RohanDhameja/Project-CleanLoom/README.md

# CleanLoom: Lint Control Solution for Small Weaving Workshops

## Project Overview

**Mission**: Develop a low-cost, practical lint reduction system for small weaving workshops in India to improve worker health, productivity, and fabric quality.

## The Problem

Small weaving workshops across India face serious lint accumulation issues:
- Workers exposed to airborne cotton fibers for extended periods
- Health impacts: respiratory issues, eye irritation, throat problems
- Productivity loss due to machine maintenance and cleaning
- Reduced fabric quality from lint contamination
- Increased machinery wear and maintenance costs

## Project Status

🚀 **Phase**: Problem Definition & Research  
📅 **Started**: December 2025  
👥 **Team**: [Add team members]

## 🚀 New to the Project?

**→ Start with [START_HERE.md](./START_HERE.md)** - Simple guide, not overwhelming!

**→ Need to set up for your team?** See [TEAM_SETUP.md](./TEAM_SETUP.md)

**→ Ready to deploy?** See [DEPLOYMENT_GUIDE.md](./DEPLOYMENT_GUIDE.md)

## Quick Navigation

- **[Project Plan](./01_Project_Plan/PROJECT_ROADMAP.md)** - Detailed timeline and milestones
- **[Problem Research](./02_Problem_Research/)** - Evidence, data, and analysis
- **[Solution Ideas](./03_Solution_Ideation/)** - Brainstorming and concepts
- **[Prototypes](./04_Prototypes/)** - Design files and prototypes
- **[Testing & Validation](./05_Testing/)** - Field tests and feedback
- **[Documentation](./06_Documentation/)** - Technical docs and guides
- **[Business Planning](./07_Business/)** - Cost analysis and implementation

## Current Focus

1. Complete problem documentation and evidence gathering
2. Conduct stakeholder interviews with workshop owners and workers
3. Research existing solutions and identify gaps
4. Begin solution ideation and concept development

## How to Contribute

This project follows a structured problem-solving approach:
1. Understand the problem deeply
2. Generate multiple solution concepts
3. Evaluate and select promising solutions
4. Build and test prototypes
5. Iterate based on feedback
6. Plan for implementation and scale

---

*Last Updated: December 3, 2025*
