RohanDhameja/Project-CleanLoom/01_Project_Plan/PROJECT_ROADMAP.md

# CleanLoom Project Roadmap

## Vision Statement

Create an affordable, effective lint control solution that can be adopted by hundreds of small weaving workshops across India, improving worker health and workshop productivity without disrupting traditional weaving practices.

---

## Project Phases

### Phase 1: Problem Definition & Research (Weeks 1-4)

**Goal**: Deeply understand the problem, stakeholders, and context

#### Week 1-2: Problem Documentation
- [ ] Document current problem with photos and evidence
- [ ] Create stakeholder map (workers, owners, suppliers, buyers)
- [ ] List all problem impacts (health, productivity, quality, costs)
- [ ] Define success metrics (lint reduction %, cost, ease of use)

#### Week 3-4: Field Research
- [ ] Visit 5-10 workshops to observe and document
- [ ] Interview workshop owners about pain points and budgets
- [ ] Interview workers about daily challenges
- [ ] Measure room dimensions, lint density, airflow patterns
- [ ] Document existing coping mechanisms

**Deliverables**:
- Problem statement document
- Stakeholder interview summaries
- Workshop measurement data
- Photo/video documentation

---

### Phase 2: Research & Benchmarking (Weeks 5-6)

**Goal**: Learn from existing solutions and identify opportunities

#### Tasks
- [ ] Research industrial lint control systems
- [ ] Study low-cost filtration methods
- [ ] Investigate natural ventilation solutions
- [ ] Review DIY air filtration projects
- [ ] Analyze competitors and alternatives
- [ ] Identify technology constraints (power, space, cost)

**Deliverables**:
- Competitive analysis document
- Technology research report
- Constraint and requirement list

---

### Phase 3: Solution Ideation (Weeks 7-8)

**Goal**: Generate multiple solution concepts

#### Brainstorming Sessions
- [ ] Individual brainstorming (quantity over quality)
- [ ] Team brainstorming sessions
- [ ] Sketch 20+ different concepts
- [ ] Consider: filtration, ventilation, capture, prevention
- [ ] Think: low-tech, mid-tech, high-tech options

#### Solution Categories to Explore
1. **Air Filtration**: Box fans with filters, ceiling-mounted units
2. **Ventilation**: Passive vents, exhaust fans, air circulation
3. **Source Capture**: Attachments to looms, localized suction
4. **Protective Equipment**: Improved masks, protective gear
5. **Maintenance Tools**: Cleaning equipment, schedules
6. **Hybrid Approaches**: Combining multiple methods

**Deliverables**:
- 20+ solution sketches/concepts
- Initial feasibility assessment

---

### Phase 4: Concept Evaluation & Selection (Weeks 9-10)

**Goal**: Narrow down to 2-3 most promising solutions

#### Evaluation Criteria
- **Cost**: Can it be built for under ₹5,000-10,000?
- **Effectiveness**: Will it reduce lint by 50%+?
- **Ease of Use**: Can users operate and maintain it?
- **Durability**: Will it last 2+ years with minimal maintenance?
- **Scalability**: Can it be replicated across workshops?
- **Cultural Fit**: Does it align with existing practices?

#### Tasks
- [ ] Create evaluation matrix
- [ ] Score each concept against criteria
- [ ] Get feedback from potential users
- [ ] Select top 2-3 concepts for prototyping
- [ ] Create detailed design specifications

**Deliverables**:
- Evaluation matrix with scores
- Top 3 selected concepts
- Design specifications document

---

### Phase 5: Prototype Development (Weeks 11-14)

**Goal**: Build working prototypes of selected solutions

#### Prototype 1 (Week 11-12)
- [ ] Source materials locally
- [ ] Build first prototype
- [ ] Basic functionality testing
- [ ] Document build process and costs

#### Prototype 2 (Week 12-13)
- [ ] Build second concept prototype
- [ ] Compare performance with Prototype 1
- [ ] Identify improvements needed

#### Prototype 3 (Week 13-14)
- [ ] Build third concept (if needed)
- [ ] Refine most promising design
- [ ] Create build instructions

**Deliverables**:
- 2-3 working prototypes
- Build documentation with photos
- Bill of materials with costs
- Performance test results

---

### Phase 6: Field Testing (Weeks 15-18)

**Goal**: Test prototypes in real workshop conditions

#### Testing Plan
- [ ] Install prototypes in 3-5 workshops
- [ ] Run for 2-4 weeks in real conditions
- [ ] Measure lint reduction (before/after)
- [ ] Collect user feedback daily/weekly
- [ ] Document failures and issues
- [ ] Monitor worker satisfaction
- [ ] Measure impact on productivity

#### Metrics to Track
- Lint density (visual/measured)
- User satisfaction (surveys)
- Downtime for cleaning
- Fabric quality improvements
- Maintenance required
- Cost of operation

**Deliverables**:
- Field test report
- User feedback summaries
- Performance data
- Improvement recommendations

---

### Phase 7: Iteration & Refinement (Weeks 19-20)

**Goal**: Improve the design based on field feedback

#### Tasks
- [ ] Analyze all feedback and data
- [ ] Identify design improvements
- [ ] Build refined prototype v2.0
- [ ] Test improvements
- [ ] Finalize design for production

**Deliverables**:
- Refined prototype
- Final design specifications
- Manufacturing guidelines

---

### Phase 8: Documentation & Planning (Weeks 21-22)

**Goal**: Prepare for implementation and scaling

#### Tasks
- [ ] Create user manual (with visuals)
- [ ] Create installation guide
- [ ] Create maintenance schedule
- [ ] Document troubleshooting steps
- [ ] Calculate cost structure
- [ ] Plan manufacturing/distribution
- [ ] Create training materials

**Deliverables**:
- Complete user documentation
- Business plan for scaling
- Training materials
- Cost and pricing analysis

---

### Phase 9: Pilot Implementation (Weeks 23-26)

**Goal**: Deploy to 10-20 workshops

#### Tasks
- [ ] Select pilot workshop locations
- [ ] Train workshop owners
- [ ] Install systems
- [ ] Provide ongoing support
- [ ] Monitor performance
- [ ] Gather case studies

**Deliverables**:
- 10-20 installations
- Case studies and testimonials
- Impact report

---

### Phase 10: Scale & Outreach (Ongoing)

**Goal**: Expand adoption across India

#### Tasks
- [ ] Partner with weaving associations
- [ ] Seek funding/grants
- [ ] Build production partnerships
- [ ] Create marketing materials
- [ ] Measure community impact

---

## Key Milestones

| Milestone | Target Date | Status |
|---|---|---|
| Project kickoff | Week 1 | ✅ |
| Problem documentation complete | Week 2 | 🔄 |
| Field research complete | Week 4 | ⏳ |
| Solution concepts generated | Week 8 | ⏳ |
| Top concepts selected | Week 10 | ⏳ |
| First prototype built | Week 12 | ⏳ |
| Field testing begins | Week 15 | ⏳ |
| Design finalized | Week 20 | ⏳ |
| Pilot deployment complete | Week 26 | ⏳ |

**Legend**: ✅ Complete | 🔄 In Progress | ⏳ Upcoming

---

## Success Metrics

### Primary Metrics
- **Lint Reduction**: 50%+ reduction in airborne and settled lint
- **Cost**: Solution costs ≤ ₹10,000 per workshop
- **Adoption**: 50+ workshops using the solution within 1 year
- **Health**: 70%+ of workers report reduced respiratory issues

### Secondary Metrics
- Fabric quality improvement (fewer defects)
- Reduced machine maintenance frequency
- Increased daily productivity
- Worker satisfaction scores
- Workshop owner satisfaction

---

## Risk Management

| Risk | Impact | Mitigation |
|---|---|---|
| Solution too expensive | High | Focus on local materials, DIY assembly |
| Low adoption rate | High | Co-design with users, ensure cultural fit |
| Ineffective lint reduction | High | Test multiple approaches, iterate quickly |
| Maintenance too complex | Medium | Design for simplicity, create clear guides |
| Funding limitations | Medium | Start small, bootstrap, seek grants later |

---

## Team Roles (To Be Assigned)

- **Project Lead**: Overall coordination and decision-making
- **Research Lead**: Field studies and user interviews
- **Design/Engineering**: Prototype development
- **Testing**: Field testing and data collection
- **Documentation**: Creating guides and materials
- **Business/Operations**: Scaling and partnerships

---

## Budget Planning

### Phase 1-4 (Research & Design): ₹20,000-30,000
- Travel to workshops
- Documentation tools
- Research materials

### Phase 5-6 (Prototyping & Testing): ₹50,000-100,000
- Materials for 3 prototypes
- Testing equipment
- Installation costs

### Phase 7-9 (Refinement & Pilot): ₹200,000-300,000
- Refined prototypes
- Pilot installations (10-20 units)
- Training and support

### Phase 10 (Scale): TBD
- Manufacturing partnerships
- Marketing and outreach
- Ongoing support

---

*Last Updated: December 3, 2025*
