RohanDhameja/Project-CleanLoom/START_HERE.md

# 👋 Welcome to CleanLoom!

## What is this project?

We're creating a **low-cost solution to reduce lint** in small weaving workshops in India. This will help thousands of workers breathe cleaner air and work in better conditions.

---

## 🚀 New to the project? Start here!

### Step 1: Understand the Problem (5 minutes)

Read this one file:
- **[02_Problem_Research/INITIAL_EVIDENCE.md](02_Problem_Research/INITIAL_EVIDENCE.md)**

That's it! This tells you everything about what we're trying to solve.

---

### Step 2: Know What Phase We're In (2 minutes)

Check the **[Current Status](#current-status)** section below to see what we're working on right now.

---

### Step 3: Jump In!

Based on what we're doing now, pick ONE action:

**If we're doing research:**
- Join a workshop visit (we'll give you templates)
- Review workshop photos
- Talk to a weaver

**If we're brainstorming:**
- Join a brainstorming session
- Sketch 5 ideas
- Research similar solutions

**If we're building:**
- Help build a prototype
- Test something
- Take photos

**If we're testing:**
- Visit a test site
- Collect feedback
- Measure results

---

## 📍 Current Status

**Phase**: Problem Research & Documentation  
**Week**: 1 of 26  
**Focus**: Understanding the problem deeply

**This Week's Goals:**
- [ ] Visit 3-5 workshops
- [ ] Interview workshop owners
- [ ] Take lots of photos
- [ ] Document what we see

**How you can help right now:**
- Review the workshop photos we have
- Come on a workshop visit
- Share ideas about solutions you've seen

---

## 📚 Need More Detail?

**Most people won't need these**, but they're here if you want to go deeper:

### Quick Guides (read if you're doing this task)
- Going on a workshop visit? → [Field Observation Template](02_Problem_Research/FIELD_OBSERVATION_TEMPLATE.md)
- Interviewing someone? → [Interview Template](02_Problem_Research/INTERVIEW_TEMPLATE.md)
- Want the full timeline? → [Project Roadmap](01_Project_Plan/PROJECT_ROADMAP.md)

### Reference Documents (use when you need them)
- [Full Project Guide](PROJECT_GUIDE.md) - How everything works
- [Folder Structure](FOLDER_STRUCTURE.md) - Where to save what
- [README](README.md) - Detailed project overview

---

## ❓ Common Questions

**Q: Do I need to read everything?**  
**A:** No! Just read INITIAL_EVIDENCE.md and check Current Status above. That's enough to start.

**Q: Where do I save my work?**  
**A:** We'll show you when you need to. Don't worry about it yet.

**Q: What if I have an idea?**  
**A:** Share it! Text/WhatsApp/email anyone on the team, or just tell us in person.

**Q: I'm confused about something**  
**A:** Ask anyone on the team. We're all learning together.

**Q: Can I change these documents?**  
**A:** Yes! That's the whole point. If something isn't clear, make it better.

---

## 👥 Team

**Core Team:**
- [Add names and roles]
- Contact: [Add contact info]

**How we work:**
- Weekly check-ins: [Day/Time]
- Communication: [WhatsApp group / Slack / Email]
- Questions: Just ask!

---

## 🎯 The Big Picture (Simple Version)

### The Problem
Workers in weaving workshops breathe lint-filled air all day. It's bad for their health.

### Our Goal
Create a simple, cheap solution (under ₹10,000) that removes 50%+ of the lint from the air.

### How We'll Do It
1. **Understand** the problem (Weeks 1-6)
2. **Brainstorm** solutions (Weeks 7-10)
3. **Build** prototypes (Weeks 11-18)
4. **Test** in real workshops (Weeks 15-20)
5. **Deploy** to many workshops (Weeks 21+)

### Success Looks Like
- Cleaner air in workshops
- Healthier workers
- Better fabric quality
- 50+ workshops using our solution in 1 year

---

## 📅 This Week's Schedule

**Monday**: [Add activity]  
**Wednesday**: [Add activity]  
**Friday**: [Add activity]

**Next workshop visit**: [Date/Time/Location]

---

## 🎉 Quick Wins

Let's celebrate small progress:
- ✅ Project structure set up
- ⏳ First workshop visit
- ⏳ First interview completed
- ⏳ 10 solution ideas
- ⏳ First prototype built

---

## 💡 Remember

- **Start small** - You don't need to understand everything
- **Ask questions** - No question is too basic
- **One step at a time** - We'll guide you through each phase
- **It's okay to be confused** - This is complex, we're figuring it out together
- **You belong here** - Your perspective is valuable

---

## 🔗 Quick Links

**For today:**
- [What's the problem?](02_Problem_Research/INITIAL_EVIDENCE.md) ← **Start here**

**When you need them:**
- [Workshop visit checklist](02_Problem_Research/FIELD_OBSERVATION_TEMPLATE.md)
- [Interview questions](02_Problem_Research/INTERVIEW_TEMPLATE.md)
- [Full roadmap](01_Project_Plan/PROJECT_ROADMAP.md)
- [How to use this project](PROJECT_GUIDE.md)

---

**Ready? Read [INITIAL_EVIDENCE.md](02_Problem_Research/INITIAL_EVIDENCE.md) and you're good to go!** 🚀

---

*Last Updated: December 3, 2025*  
*Questions? Contact: [Add contact]*
