RohanDhameja/Project-CleanLoom/graphs/g10_timeline_gantt.png

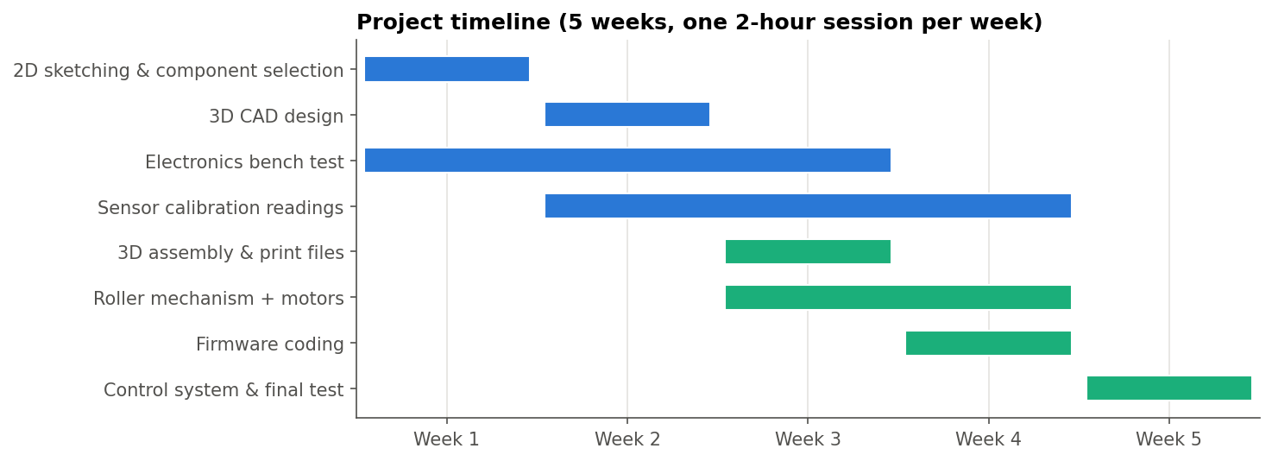
graphs/g10_timeline_gantt.png
