RohanDhameja/Project-CleanLoom/images/photo13_electronics_in_base_3.jpg

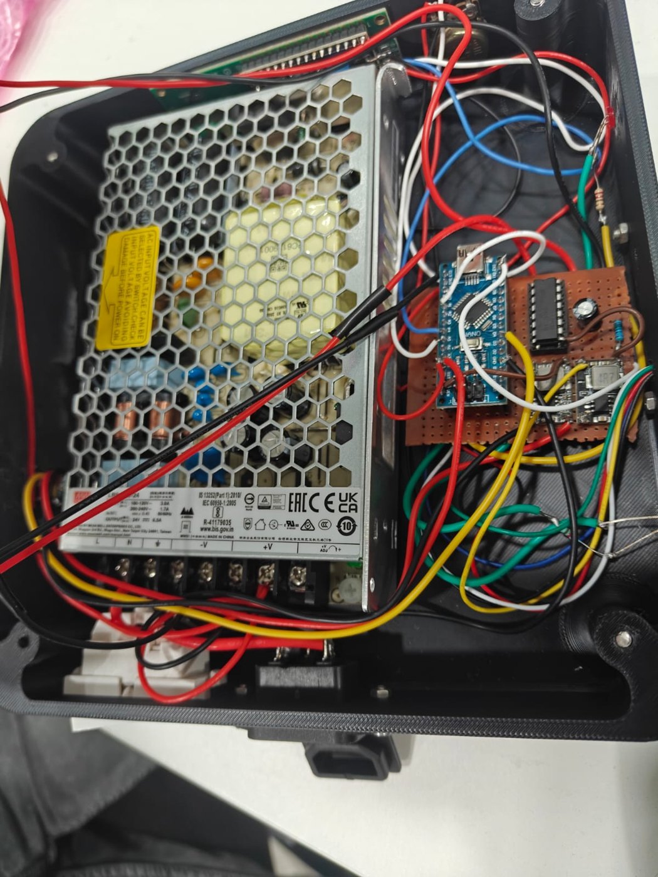
images/photo13_electronics_in_base_3.jpg
