RohanDhameja/Project-CleanLoom/NEXT_STEPS_PLAN.md

# Next Steps Plan - Answering Key Questions

## Question 1: What are the next steps? How do we proceed?

### Immediate Next Steps (This Week - Week 1)

**Step 1: Consolidate What We Know (Days 1-2)**
- Collect all existing research from team members
- Document existing solutions they've found
- List all workshop observations we have
- Create a shared knowledge base

**Step 2: Plan Field Visits (Days 3-4)**
- Identify 5-10 workshops to visit (with permission)
- Prepare observation checklist
- Prepare interview questions
- Schedule visits

**Step 3: First Field Visit (Day 5)**
- Visit 2-3 workshops
- Take photos and measurements
- Interview owners and workers
- Document everything

### Short-Term Steps (Weeks 2-4)

**Week 2: Deep Research**
- Complete 5-10 workshop visits
- Document all findings
- Research existing solutions in detail
- Identify gaps and opportunities

**Week 3: Analysis**
- Analyze all collected data
- Identify patterns and common problems
- Understand constraints (cost, space, power, etc.)
- Define success criteria

**Week 4: Solution Ideation**
- Brainstorm 20+ solution concepts
- Consider multiple approaches (technical, behavioral, hybrid)
- Evaluate initial feasibility
- Select 3-5 concepts for deeper exploration

### Medium-Term Steps (Weeks 5-12)

**Weeks 5-8: Prototype Development**
- Build 2-3 prototype solutions
- Test in controlled environment
- Refine designs
- Calculate costs

**Weeks 9-12: Field Testing**
- Install prototypes in 3-5 workshops
- Test for 2-4 weeks
- Collect feedback
- Measure effectiveness

### Long-Term Steps (Weeks 13+)

**Weeks 13-16: Refinement**
- Improve designs based on feedback
- Finalize solution
- Create user documentation

**Weeks 17-20: Pilot Deployment**
- Deploy to 10-20 workshops
- Provide training and support
- Monitor performance

**Weeks 21+: Scale**
- Expand to more workshops
- Build partnerships
- Measure impact

---

## Question 2: What will be the nature of the solution?

### Our Approach: **Hybrid Solution** (Technical + Behavioral + Social)

We believe the solution needs multiple components:

### 1. **Technical Component** (Primary)
**What:** A physical device/system that removes lint from the air

**Options we're exploring:**
- Air filtration systems (fans + filters)
- Ventilation improvements
- Source capture (capturing lint at the loom)
- Combination approaches

**Why technical is needed:**
- The problem is physical (airborne lint)
- Requires a physical intervention
- Can be measured objectively

**Constraints:**
- Must be affordable (under ₹10,000)
- Must use minimal power
- Must be simple to install and maintain
- Must work in existing workshop spaces

### 2. **Behavioral Component** (Supporting)
**What:** Changes in how workshops operate

**Examples:**
- Regular cleaning schedules
- Proper maintenance routines
- Usage protocols for the technical solution

**Why behavioral is needed:**
- Technical solutions only work if used correctly
- Maintenance is critical for long-term success
- Workers need to adopt new habits

**How we'll address it:**
- Simple, visual instructions
- Training sessions
- Easy-to-follow maintenance schedules
- Design for "set and forget" where possible

### 3. **Social Component** (Enabling)
**What:** Community support and adoption

**Examples:**
- Peer learning (workshop owners teaching each other)
- Group purchasing for better prices
- Sharing success stories
- Building trust in the solution

**Why social is needed:**
- Small workshops learn from each other
- Group adoption creates momentum
- Community validation increases trust
- Can reduce costs through bulk purchasing

**How we'll address it:**
- Start with a few pilot workshops
- Document success stories
- Create simple sharing mechanisms
- Build a network of early adopters

### 4. **Economic Component** (Critical)
**What:** Making it financially viable

**Considerations:**
- Affordable initial cost
- Low operating costs
- Clear ROI for workshop owners
- Potential financing options

**Why economic is critical:**
- Small workshops operate on tight margins
- Must demonstrate value quickly
- May need payment plans or subsidies

---

### Most Likely Solution Type: **Technical (with behavioral support)**

**Primary:** A low-cost air filtration or ventilation system
**Supporting:** Simple maintenance protocols and usage guidelines
**Enabling:** Community adoption and peer learning

**Why this combination:**
- Technical solution addresses the root cause (airborne lint)
- Behavioral component ensures it's used effectively
- Social component enables adoption at scale

---

## Question 3: How are we going to collect pictorial evidence?

### Evidence Collection Strategy

### Phase 1: Permission & Planning (Before Visits)

**Step 1: Get Consent**
- Contact workshop owners in advance
- Explain the project purpose
- Ask permission to photograph
- Offer to share photos with them
- Respect privacy requests (blur faces if needed)

**Step 2: Prepare Equipment**
- Smartphone cameras (most accessible)
- Optional: DSLR for better quality
- Measuring tape for scale
- Notebook for notes

**Step 3: Plan What to Capture**
- Wide shots of entire workshop
- Close-ups of lint accumulation
- Machine details showing lint buildup
- Ceiling and walls showing dust
- Workers (with permission)
- Ventilation points (or lack thereof)
- Any existing solutions they've tried

### Phase 2: During Visits

**Photo Checklist:**

**Workshop Overview:**
- [ ] Exterior of workshop
- [ ] Interior wide shot showing all looms
- [ ] Layout and spacing

**Lint Evidence:**
- [ ] Close-up of lint on machines (gears, frames)
- [ ] Lint on ceiling and walls
- [ ] Lint on floor
- [ ] Lint on fabric being woven
- [ ] Airborne lint (if visible in light beam)

**Infrastructure:**
- [ ] Ventilation (windows, doors, fans)
- [ ] Electrical setup
- [ ] Room dimensions (use person/object for scale)
- [ ] Ceiling height

**People & Process:**
- [ ] Workers (with permission, faces blurred if requested)
- [ ] Loom operation
- [ ] Cleaning activities
- [ ] Any protective equipment used

**Existing Solutions:**
- [ ] Any filters or devices already installed
- [ ] Cleaning tools and methods
- [ ] What they've tried before

### Phase 3: Organization & Storage

**File Naming Convention:**
```
YYYYMMDD_Location_Subject_###.jpg

Examples:
20251203_Workshop_A_LintOnMachine_001.jpg
20251203_Workshop_A_WideShot_002.jpg
20251203_Workshop_B_CeilingLint_001.jpg
```

**Storage:**
- Upload to GitHub: `08_Assets/Photos/Workshop_Photos/`
- Also backup to Google Drive or similar
- Create a simple spreadsheet listing all photos with descriptions

**Privacy:**
- Get written/verbal consent before photographing people
- Blur faces if requested
- Don't share identifiable photos publicly without permission
- Keep contact information private

### Phase 4: Documentation

**For Each Photo:**
- Date and location
- What it shows
- Why it's important
- Any relevant measurements or notes

**Create Photo Log:**
- Simple spreadsheet or document
- Links photos to observations
- Makes it easy to find specific evidence later

---

### Practical Tips for Evidence Collection

**1. Start with Phone Cameras**
- Everyone has one
- Good enough quality
- Easy to share immediately
- Can upgrade later if needed

**2. Take More Than You Think You Need**
- Better to have too many than too few
- Can delete later
- Different angles tell different stories

**3. Include Scale References**
- Person standing next to machine
- Common object (water bottle, notebook)
- Measuring tape visible in shot

**4. Document Context**
- What was happening when photo was taken?
- Time of day
- How many looms were running
- Any unusual conditions

**5. Respect Privacy**
- Always ask before photographing people
- Explain how photos will be used
- Offer to share copies with workshop owners
- Blur faces if requested

**6. Show Before/After (Later)**
- When testing solutions, take photos from same angles
- Makes impact visible and compelling

---

### Timeline for Evidence Collection

**Week 1-2:** 
- Visit 5-10 workshops
- Collect 50-100 photos
- Document all observations

**Week 3:**
- Organize and catalog all photos
- Create photo log
- Identify gaps (need more photos of X)

**Week 4:**
- Fill gaps with additional visits if needed
- Finalize evidence collection
- Use photos in problem documentation

**Ongoing:**
- Continue collecting photos during testing
- Document prototypes and results
- Build before/after comparison library

---

## Summary: Answering Your Friend's Questions

### 1. Next Steps:
- **This week:** Consolidate existing knowledge, plan field visits
- **Weeks 2-4:** Deep research, visit 5-10 workshops, analyze findings
- **Weeks 5-12:** Build and test prototypes
- **Weeks 13+:** Refine and scale

### 2. Solution Nature:
- **Primary:** Technical (air filtration/ventilation system)
- **Supporting:** Behavioral (maintenance protocols)
- **Enabling:** Social (community adoption)
- **Critical:** Economic (affordable, clear ROI)

### 3. Pictorial Evidence:
- **Permission first:** Always ask before photographing
- **Systematic approach:** Use checklist, consistent naming
- **Privacy respect:** Blur faces if requested, get consent
- **Organization:** Store in GitHub, create photo log
- **Timeline:** Collect 50-100 photos in first 2 weeks

---

*This plan ensures we proceed systematically while respecting the people and places we're working with.*
