RohanDhameja/Project-CleanLoom/data/04_filtration_performance_test.csv

minute | phase | fan_state | dust_mg_m3 | threshold_mg_m3 | warning_led
0 | Site work ON, filter OFF | OFF | 6.2 | 10 | OFF
1 | Site work ON, filter OFF | OFF | 7.63 | 10 | OFF
2 | Site work ON, filter OFF | OFF | 9.31 | 10 | OFF
3 | Site work ON, filter OFF | OFF | 8.64 | 10 | OFF
4 | Site work ON, filter OFF | OFF | 9.15 | 10 | OFF
5 | Site work ON, filter OFF | OFF | 11.18 | 10 | ON
6 | Site work ON, filter OFF | OFF | 9.56 | 10 | OFF
7 | Site work ON, filter OFF | OFF | 10.09 | 10 | ON
8 | Site work ON, filter OFF | OFF | 12.54 | 10 | ON
9 | Site work ON, filter OFF | OFF | 13.37 | 10 | ON
10 | Site work ON, filter OFF | OFF | 14.19 | 10 | ON
11 | Site work ON, filter OFF | OFF | 12.35 | 10 | ON
12 | Site work ON, filter OFF | OFF | 12.02 | 10 | ON
13 | Site work ON, filter OFF | OFF | 13.77 | 10 | ON
14 | Site work ON, filter OFF | OFF | 13.2 | 10 | ON
15 | Site work ON, filter OFF | OFF | 14.15 | 10 | ON
16 | Site work ON, filter OFF | OFF | 14.09 | 10 | ON
17 | Site work ON, filter OFF | OFF | 12.83 | 10 | ON
18 | Site work ON, filter OFF | OFF | 13.5 | 10 | ON
19 | Site work ON, filter OFF | OFF | 11.87 | 10 | ON
20 | Site work ON, filter OFF | OFF | 13.11 | 10 | ON
21 | Site work ON, filter OFF | OFF | 15.38 | 10 | ON
22 | Site work ON, filter OFF | OFF | 14.75 | 10 | ON
23 | Site work ON, filter OFF | OFF | 13.76 | 10 | ON
24 | Site work ON, filter OFF | OFF | 13.19 | 10 | ON
25 | Site work ON, filter OFF | OFF | 14.99 | 10 | ON
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
163 | Site work OFF, filter ON | ON | 3.44 | 10 | OFF
164 | Site work OFF, filter ON | ON | 2.76 | 10 | OFF
165 | Site work OFF, filter ON | ON | 3.43 | 10 | OFF
166 | Site work OFF, filter ON | ON | 2.68 | 10 | OFF
167 | Site work OFF, filter ON | ON | 2.91 | 10 | OFF
168 | Site work OFF, filter ON | ON | 3.36 | 10 | OFF
169 | Site work OFF, filter ON | ON | 3.1 | 10 | OFF
170 | Site work OFF, filter ON | ON | 3.21 | 10 | OFF
171 | Site work OFF, filter ON | ON | 3.07 | 10 | OFF
172 | Site work OFF, filter ON | ON | 3.07 | 10 | OFF
173 | Site work OFF, filter ON | ON | 2.59 | 10 | OFF
174 | Site work OFF, filter ON | ON | 2.25 | 10 | OFF
175 | Site work OFF, filter ON | ON | 3.53 | 10 | OFF
176 | Site work OFF, filter ON | ON | 2.35 | 10 | OFF
177 | Site work OFF, filter ON | ON | 2.8 | 10 | OFF
178 | Site work OFF, filter ON | ON | 2.73 | 10 | OFF
179 | Site work OFF, filter ON | ON | 2.92 | 10 | OFF
