RohanDhameja/Project-CleanLoom/03_Solution_Ideation/EVALUATION_FRAMEWORK.md

# Solution Evaluation Framework

## Purpose

This framework helps evaluate and compare solution concepts to identify the most promising approaches for prototyping. Use this after the ideation phase to narrow down from 20+ concepts to 2-3 finalists.

---

## Evaluation Process

### Step 1: Initial Screening
Remove ideas that are clearly not feasible due to:
- Far exceeds budget (>₹50,000)
- Requires unavailable technology
- Not culturally appropriate
- Violates safety standards

### Step 2: Criteria-Based Scoring
Score remaining concepts using the matrix below

### Step 3: User Feedback
Get input from 3-5 potential users on top 8-10 concepts

### Step 4: Final Selection
Select 2-3 concepts for prototyping based on scores + user feedback

---

## Evaluation Criteria Matrix

### Criteria & Weighting

| Criteria | Weight | Why It Matters |
|---|---|---|
| Cost | 20% | Must be affordable for small workshops |
| Effectiveness | 25% | Must significantly reduce lint (50%+) |
| Ease of Use | 15% | Users have limited technical skills |
| Ease of Maintenance | 10% | Ongoing complexity will lead to abandonment |
| Installation Difficulty | 10% | Cannot disrupt work for long |
| Durability | 10% | Must last 2+ years with minimal repair |
| Scalability | 5% | Can it work for 1 loom or 10 looms? |
| Safety | 5% | Cannot introduce new hazards |

**Total: 100%**

---

## Scoring Guide

**For each criterion, rate 1-5:**

### 1. Cost (20% weight)

| Score | Cost Range | Description |
|---|---|---|
| 5 | < ₹5,000 | Extremely affordable |
| 4 | ₹5,000-8,000 | Very affordable |
| 3 | ₹8,000-12,000 | Affordable |
| 2 | ₹12,000-20,000 | Expensive but possible |
| 1 | > ₹20,000 | Too expensive |

---

### 2. Effectiveness (25% weight)

| Score | Lint Reduction | Description |
|---|---|---|
| 5 | 80-100% | Dramatic improvement |
| 4 | 60-80% | Significant improvement |
| 3 | 40-60% | Noticeable improvement |
| 2 | 20-40% | Marginal improvement |
| 1 | < 20% | Minimal improvement |

*Note: Estimates are okay at this stage*

---

### 3. Ease of Use (15% weight)

| Score | Complexity | Description |
|---|---|---|
| 5 | Passive | No user action required (set and forget) |
| 4 | Very Simple | On/off switch only |
| 3 | Simple | Few controls, intuitive |
| 2 | Moderate | Requires some training |
| 1 | Complex | Requires technical knowledge |

---

### 4. Ease of Maintenance (10% weight)

| Score | Maintenance | Description |
|---|---|---|
| 5 | < 15 min/month | Minimal maintenance |
| 4 | 15-30 min/week | Weekly simple tasks |
| 3 | 30-60 min/week | Regular cleaning/adjustment |
| 2 | > 1 hr/week | Significant maintenance |
| 1 | Professional service needed | Requires technician |

---

### 5. Installation Difficulty (10% weight)

| Score | Installation | Description |
|---|---|---|
| 5 | < 2 hours | Plug and play or very simple mounting |
| 4 | Half day | DIY with basic tools |
| 3 | 1 day | DIY with some help |
| 2 | 2-3 days | Requires some expertise |
| 1 | > 3 days | Requires professional installation |

---

### 6. Durability (10% weight)

| Score | Lifespan | Description |
|---|---|---|
| 5 | 5+ years | Extremely durable |
| 4 | 3-5 years | Very durable |
| 3 | 2-3 years | Adequate durability |
| 2 | 1-2 years | May need replacement |
| 1 | < 1 year | Poor durability |

---

### 7. Scalability (5% weight)

| Score | Scalability | Description |
|---|---|---|
| 5 | Fully modular | Works for 1-20 looms easily |
| 4 | Highly scalable | Minor adjustments needed |
| 3 | Moderately scalable | Some redesign for different sizes |
| 2 | Limited scalability | Only works for specific setup |
| 1 | Not scalable | Fixed size only |

---

### 8. Safety (5% weight)

| Score | Safety | Description |
|---|---|---|
| 5 | Very safe | No safety concerns |
| 4 | Safe | Minor precautions needed |
| 3 | Acceptable | Moderate safety measures needed |
| 2 | Concerning | Significant safety concerns |
| 1 | Unsafe | Creates new hazards |

---

## Scoring Template

Use this table for each concept:

```
CONCEPT NAME: _______________________________

| Criterion | Raw Score (1-5) | Weight | Weighted Score |
|-----------|----------------|--------|----------------|
| Cost | ___ | × 0.20 | = ____ |
| Effectiveness | ___ | × 0.25 | = ____ |
| Ease of Use | ___ | × 0.15 | = ____ |
| Ease of Maintenance | ___ | × 0.10 | = ____ |
| Installation Difficulty | ___ | × 0.10 | = ____ |
| Durability | ___ | × 0.10 | = ____ |
| Scalability | ___ | × 0.05 | = ____ |
| Safety | ___ | × 0.05 | = ____ |
| **TOTAL** | | | **____** |

Max Possible Score: 5.0
```

---

## User Feedback Template

Show concepts to potential users and ask:

### Questions for Workshop Owners

1. **First Impression**: On a scale of 1-5, how interested are you in this solution?
   
   Score: _____

2. **Affordability**: Would you pay [estimated cost] for this?
   
   [ ] Yes [ ] Maybe [ ] No

3. **Concerns**: What worries you about this solution?
   
   ____________________________________________________________

4. **Confidence**: Do you think this would actually work in your workshop?
   
   [ ] Yes, definitely [ ] Probably [ ] Not sure [ ] Probably not [ ] No

---

### Questions for Workers

1. **Comfort**: Would you feel comfortable working with this running?
   
   [ ] Yes [ ] Maybe [ ] No - Why? _________________________

2. **Interference**: Do you think it would get in your way?
   
   [ ] No [ ] A little [ ] Yes, significantly

3. **Maintenance**: Could you maintain this yourself?
   
   [ ] Yes, easily [ ] Yes, with training [ ] Not sure [ ] No

---

## Comparison Matrix

Create a spreadsheet with all concepts as rows and criteria as columns:

| Concept | Cost | Effectiveness | Ease of Use | ... | **Total** | **Rank** |
|---|---|---|---|-----|---|---|
| Concept A | 4.0 | 3.5 | 4.0 | ... | 3.85 | 1 |
| Concept B | 3.0 | 4.5 | 3.0 | ... | 3.65 | 2 |
| ... | | | | | | |

---

## Additional Considerations

### Technical Feasibility Questions

For top concepts, answer:

- [ ] Can we source materials locally?
- [ ] Do we have the skills to build it?
- [ ] Can it be built with available tools?
- [ ] Are there any regulatory/compliance issues?
- [ ] What could go wrong during operation?

### Market Research

- Are similar solutions available commercially?
- If yes, why aren't they being used? (price, complexity, cultural fit?)
- Can we improve on existing solutions?

### Pilot Testing Suitability

- Can we build a prototype in 2-4 weeks?
- Is it safe to test in a real workshop?
- Can we measure its effectiveness?
- What metrics will we track?

---

## Decision Framework

### Must-Have Thresholds
- Total score: ≥ 3.5 / 5.0
- Cost score: ≥ 3
- Effectiveness score: ≥ 3
- Safety score: ≥ 4
- User feedback: ≥ 60% positive

### Selection Strategy

**Select 2-3 concepts that**:
1. Score highest overall
2. Represent different approaches (e.g., filtration + ventilation + source capture)
3. Have strong user enthusiasm
4. Have manageable risk profiles
5. Can be prototyped quickly

**Rationale for multiple concepts**:
- Prototypes may fail - have backups
- Different workshops may need different solutions
- Can combine best features later

---

## Documentation Requirements

For each selected concept, create:

1. **Detailed Design Sketch**
   - Dimensions, materials, components
   - How it works (step-by-step)
   
2. **Bill of Materials (BOM)**
   - Every component needed
   - Where to source locally
   - Cost breakdown

3. **Build Plan**
   - Tools required
   - Steps to construct
   - Estimated build time

4. **Testing Plan**
   - How to measure effectiveness
   - Safety checks
   - User feedback method

---

## Red Flags to Watch For

⚠️ **Be cautious if**:
- Solution requires rare/expensive materials
- Maintenance is complex or frequent
- Users express skepticism or confusion
- Safety concerns are raised
- Installation requires structural changes
- Operating costs are high (electricity, consumables)

---

## Next Steps After Evaluation

1. Finalize top 2-3 concepts
2. Get team consensus on selections
3. Create detailed build plans
4. Source materials
5. Begin prototyping (move to Phase 5 of roadmap)

---

*Remember: The goal is to find solutions that are good enough to test, not perfect*  
*Prototyping will reveal what works - stay flexible*
