RohanDhameja/Project-CleanLoom/data/01_GP2Y10_sensor_calibration_readings.csv

reading_no | test_week | condition | time | adc_value | sensor_voltage_V | raw_datasheet_mg_m3 | calculated_dust_mg_m3 | reference_meter_mg_m3 | abs_error_mg_m3 | error_pct | accuracy_pct
1 | Week 2 | Clean room baseline (fan off) | 10:21:00 | 167 | 0.816 | 0.0388 | 1.29 | 1.18 | 0.11 | 9.5 | 90.5
2 | Week 2 | Clean room baseline (fan off) | 10:21:31 | 195 | 0.953 | 0.062 | 2.07 | 1.64 | 0.43 | 26.1 | 73.9
3 | Week 2 | Clean room baseline (fan off) | 10:22:02 | 234 | 1.144 | 0.0944 | 3.15 | 2.45 | 0.7 | 28.5 | 71.5
4 | Week 2 | Clean room baseline (fan off) | 10:22:38 | 203 | 0.992 | 0.0687 | 2.29 | 2.05 | 0.24 | 11.7 | 88.3
5 | Week 2 | Clean room baseline (fan off) | 10:23:04 | 157 | 0.767 | 0.0304 | 1.01 | 1.16 | 0.15 | 12.5 | 87.5
6 | Week 2 | Clean room baseline (fan off) | 10:23:45 | 217 | 1.061 | 0.0803 | 2.68 | 2.44 | 0.24 | 9.7 | 90.3
7 | Week 2 | Clean room baseline (fan off) | 10:24:26 | 203 | 0.992 | 0.0687 | 2.29 | 2.45 | 0.16 | 6.6 | 93.4
8 | Week 2 | Clean room baseline (fan off) | 10:25:01 | 166 | 0.811 | 0.0379 | 1.26 | 1.31 | 0.05 | 3.5 | 96.5
9 | Week 2 | Clean room baseline (fan off) | 10:25:43 | 178 | 0.87 | 0.0479 | 1.6 | 1.1 | 0.5 | 45.1 | 54.9
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
