RohanDhameja/Project-CleanLoom/data/05_warning_led_response_test.csv

time_s | dust_mg_m3 | threshold_mg_m3 | above_threshold | warning_led
0.0 | 5.55 | 8 | NO | OFF
0.5 | 4.87 | 8 | NO | OFF
1.0 | 5.53 | 8 | NO | OFF
1.5 | 5.45 | 8 | NO | OFF
2.0 | 5.21 | 8 | NO | OFF
2.5 | 5.06 | 8 | NO | OFF
3.0 | 4.95 | 8 | NO | OFF
3.5 | 4.84 | 8 | NO | OFF
4.0 | 4.75 | 8 | NO | OFF
4.5 | 4.83 | 8 | NO | OFF
5.0 | 5.07 | 8 | NO | OFF
5.5 | 5.1 | 8 | NO | OFF
6.0 | 5.96 | 8 | NO | OFF
6.5 | 5.11 | 8 | NO | OFF
7.0 | 5.06 | 8 | NO | OFF
7.5 | 4.99 | 8 | NO | OFF
8.0 | 5.41 | 8 | NO | OFF
8.5 | 4.95 | 8 | NO | OFF
9.0 | 4.55 | 8 | NO | OFF
9.5 | 4.9 | 8 | NO | OFF
10.0 | 13.04 | 8 | YES | OFF
10.5 | 11.84 | 8 | YES | OFF
11.0 | 13.1 | 8 | YES | OFF
11.5 | 4.96 | 8 | NO | OFF
12.0 | 5.63 | 8 | NO | OFF
12.5 | 5.25 | 8 | NO | OFF
13.0 | 5.39 | 8 | NO | OFF
13.5 | 5.04 | 8 | NO | OFF
14.0 | 4.82 | 8 | NO | OFF
14.5 | 5.21 | 8 | NO | OFF
15.0 | 4.73 | 8 | NO | OFF
15.5 | 5.62 | 8 | NO | OFF
16.0 | 5.1 | 8 | NO | OFF
16.5 | 5.0 | 8 | NO | OFF
17.0 | 5.1 | 8 | NO | OFF
17.5 | 5.52 | 8 | NO | OFF
18.0 | 5.38 | 8 | NO | OFF
18.5 | 5.46 | 8 | NO | OFF
19.0 | 5.52 | 8 | NO | OFF
19.5 | 5.4 | 8 | NO | OFF
20.0 | 10.68 | 8 | YES | OFF
20.5 | 12.25 | 8 | YES | OFF
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
