RohanDhameja/Project-CleanLoom/02_Problem_Research/INITIAL_EVIDENCE.md

# Initial Problem Evidence

## Date: December 3, 2025

This document captures the initial evidence and observations that define the lint accumulation problem in small weaving workshops.

---

## Problem Overview

Small weaving workshops in many parts of India rely on tightly packed power looms running inside enclosed, poorly ventilated rooms. As these looms operate at high speed, they release a constant stream of fine cotton fibers and lint into the air. Over time, the lint settles on every surface, including the ceiling, walls, machinery, threads, and finished fabric.

---

## Visual Evidence from Workshop Photographs

### 1. Heavy Lint Accumulation on Machinery

**Observation**: The machines are coated with a thick layer of loose fibers, especially around gears, rods, and moving parts.

**Significance**: 
- Shows continuous production and settling of lint
- Creates dusty and unsafe work environment
- Increases friction on mechanical components
- Requires frequent cleaning to maintain operation

---

### 2. Enclosed Space With No Ventilation Path

**Observation**: The room is made of brick and cement with a low, slanted roof. There are no visible windows or vents to circulate air.

**Significance**:
- With multiple looms running simultaneously, fibers accumulate faster than they can disperse
- Workers are exposed to this air for long hours every day
- Natural ventilation is impossible
- Temperature and lint concentration build up over time

---

### 3. Multiple Looms Operating Close Together

**Observation**: The workshop has several looms placed back to back with minimal spacing.

**Significance**:
- Increases the density of airborne lint
- When machines operate this close, fiber shedding multiplies
- Lint concentrates in one confined space
- Difficult to access machines for cleaning
- Workers must navigate tight spaces filled with airborne fibers

---

### 4. Dust Settling on the Ceiling and Walls

**Observation**: The upper surfaces, beams, and wiring look dusty, which is a clear indicator that lint rises and settles throughout the room.

**Significance**:
- In a healthy workspace, ceilings do not show such visible fiber buildup
- Indicates that lint is airborne for extended periods
- Demonstrates that the problem is room-wide, not just near machines
- Suggests inadequate air circulation

---

### 5. Impact on Fabric and Workflow

**Observation**: Loose fibers visible on top of the running fabric suggest that lint can land directly on the cloth during weaving.

**Significance**:
- Affects fabric cleanliness and quality
- Workers may need to stop to remove fibers from the fabric
- Slows down production
- May lead to customer complaints
- Adds extra cleaning step before fabric delivery

---

### 6. Worker Health Exposure

**Observation**: Although workers are not visible in the photo, the environment itself shows that anyone inside the room would be breathing in airborne fibers continuously.

**Significance**:
- Can cause coughing, throat irritation, eye irritation
- Long-term respiratory issues are likely
- Workers have no escape from exposure during work hours
- Most workshops lack protective equipment
- Health impacts compound over years of exposure

---

## Why This Problem Matters

### 1. Worker Health and Safety

Weavers spend hours in these rooms every day. Breathing in airborne fibers for years leads to:
- Persistent coughing
- Throat and nasal irritation
- Eye strain
- Long-term respiratory problems

Most artisans don't have access to healthcare or protective masks. Reducing lint exposure directly improves their well-being.

---

### 2. Better Working Conditions

Workshops like the one in the image are packed, warm, and dusty. Constant lint settling on workers' bodies, clothing, and hair creates discomfort. A cleaner environment makes the workspace more manageable and dignified, especially for artisans who depend on weaving for their livelihood.

---

### 3. Higher Productivity

When lint collects on gears and moving parts, machines slow down or jam. Workers stop frequently to clean or adjust the loom. This interrupts their workflow and reduces daily output. Cleaner machines run more smoothly, allowing weavers to produce more fabric with less downtime.

---

### 4. Improved Fabric Quality

Loose fibers falling onto the cloth during weaving affect the cleanliness and finish of the fabric. Weavers must manually pick out fibers before packing the cloth, increasing their workload. Reducing lint in the air leads to cleaner fabric with fewer defects.

---

### 5. Lower Maintenance Costs

Lint buildup increases friction and puts strain on machine components. Over time, this leads to wear-and-tear and higher repair costs. A lint-controlled environment extends the lifespan of old looms, which many small workshops cannot afford to replace.

---

### 6. Support for Traditional Textile Communities

These workshops are often family-run and operate on small margins. Any improvement that makes their work safer, more efficient, and more sustainable protects their income and preserves local weaving traditions.

---

### 7. Scalable Community Impact

One small solution can be adopted across hundreds of similar workshops in villages and towns. Because the setup in the photo is common across India's textile communities, a practical, low-cost lint-control system can create widespread benefits quickly.

---

## Key Insights

### The Problem is Systemic

This is not an isolated issue. The workshop shown represents thousands of similar operations across India's textile regions. The problem has these common characteristics:

- **Physical setup**: Enclosed brick/cement rooms with minimal ventilation
- **Equipment**: Multiple power looms operating at high speed in close proximity
- **Economic context**: Low-margin businesses that cannot afford industrial solutions
- **Social context**: Family-run operations with limited technical knowledge
- **Health context**: Workers with no access to protective equipment or healthcare

### The Need is Urgent

- Workers are exposed daily for hours, often for years
- Health impacts are cumulative and potentially irreversible
- The textile workforce is significant (thousands of workshops, tens of thousands of workers)
- Current "solutions" (occasional cleaning, fans) are inadequate
- No low-cost, practical solution currently exists for this market segment

### The Opportunity is Clear

A simple, affordable lint control solution designed specifically for small workshops could:
- Transform working conditions for thousands of artisans
- Preserve traditional livelihoods by making them safer and more sustainable
- Improve product quality and workshop profitability
- Serve as a model for occupational health improvements in informal sector

---

## Questions Raised by This Evidence

### Technical Questions
1. What is the actual concentration of lint in the air? (needs measurement)
2. What size particles are we dealing with? (affects filtration approach)
3. What airflow rates would be needed to make a difference?
4. Where does most lint originate on the looms?
5. What is the room volume and air change rate needed?

### User Questions
1. How much time do workers currently spend on cleaning?
2. What health symptoms do workers actually experience?
3. What have workshop owners tried before?
4. What would owners be willing to pay for a solution?
5. What installation and maintenance complexity can users handle?

### Design Questions
1. Should we focus on room-level air cleaning or source capture?
2. Can we use passive (no power) or low-power solutions?
3. What materials are locally available and affordable?
4. How can we make maintenance simple enough for low-literacy users?
5. What cultural or aesthetic factors should we consider?

---

## Next Steps

Based on this initial evidence, we need to:

1. **Visit multiple workshops** to verify that this evidence is representative
2. **Conduct detailed measurements** of lint levels, room dimensions, airflow
3. **Interview stakeholders** to understand their specific needs and constraints
4. **Document the full scope** of health, productivity, and quality impacts
5. **Research existing solutions** and why they're not being used
6. **Begin ideation** based on validated understanding of the problem

---

## Photo Documentation

**Status**: Initial photos received showing workshop environment

**Needed**:
- [ ] More photos from multiple workshops
- [ ] Close-ups of lint accumulation on specific machine parts
- [ ] Photos showing workers in the environment
- [ ] Before/after photos showing daily lint buildup
- [ ] Photos of any existing ventilation or filtration attempts
- [ ] Comparison photos of well-ventilated vs. poorly-ventilated workshops

---

## Conclusion

This photograph provides clear evidence of the need for a simple, practical lint-reduction solution designed for small weaving units. These workshops do not have modern dust extraction systems, and the workers rely on outdated machinery in enclosed rooms. A low-cost, self-managed lint control system would make the environment significantly cleaner, healthier, and safer without disrupting the weaving process.

The challenge now is to move from problem observation to solution development, guided by deep user understanding and practical constraints.

---

*Document Status*: Initial evidence capture  
*Next Update*: After field visits and stakeholder interviews  
*Last Updated*: December 3, 2025
