RohanDhameja/Project-CleanLoom/(commit log)

2025-12-03 Initial project setup - CleanLoom lint control solution framework
2026-10-11 Add project reports, datasets, graphs, images and README
    [01_GP2Y10_sensor_calibration_readings.csv, 02_motor_current_readings.csv, 03_supply_voltage_spike_readings.csv, 04_filtration_performance_test.csv, 05_warning_led_response_test.csv]
2026-10-14 Preserve Air Filter README for CleanLoom import
